DEDALUS-5x/axes-controller-board/outputs/ACB_bom.csv

Reference | Value | Footprint | Qty | LCSC
C1,C2,C3 | 10u | Capacitor_SMD:C_0603_1608Metric | 3 | C19702
C4,C5 | 15pF | Capacitor_SMD:C_0603_1608Metric | 2 | C1644
C6,C32,C33,C34,C39,C40,C41,C46,C47 | 100nF | Capacitor_SMD:C_0603_1608Metric | 9 | C14663
C10,C11 | 4.7u | Capacitor_SMD:C_0805_2012Metric | 2 | C1779
C12,C13,C15,C30,C31,C37,C38,C44,C45 | 10n | Capacitor_SMD:C_0603_1608Metric | 9 | C57112
C25,C26 | 2.2u | Capacitor_SMD:C_0805_2012Metric | 2 | C377773
C35,C36,C42,C43,C49,C50 | 220p | Capacitor_SMD:C_0603_1608Metric | 6 | C1603
D1,D2 | LED_Small | Diode_SMD:D_0603_1608Metric | 2 | C2286
D3 | B540C | Diode_SMD:D_SMC_Handsoldering | 1 | C72264
D5,D6 | LED_Small | LED_SMD:LED_0603_1608Metric | 2 | C2286
F1 | 750mA | Fuse:Fuse_0603_1608Metric | 1 | C206991
IC1 | TPS5450QDDARQ1 | Local:SOIC127P600X170-9N | 1 | C181270
IC5 | STM32H723ZGT6 | Local:QFP50P2200X2200X160-144N | 1 | C7089881
JP1 | BOOT0 | Jumper:SolderJumper-3_P1.3mm_Open_RoundedPad1.0x1.5mm | 1
L2 | 15u | Inductor_SMD:L_12x12mm_H6mm | 1 | C2847584
R1 | 2k | Resistor_SMD:R_0603_1608Metric | 1 | C22975
R2,R10,R11,R41,R42 | 1k | Resistor_SMD:R_0603_1608Metric | 5 | C21190
R3,R4,R5,R6,R7,R19,R20,R21,R22,R23,R24,R25,R26,R27,R28,R29,R30,R31,R32,R43,R44,R58,R59,R71,R72 | 33R | Resistor_SMD:R_0603_1608Metric | 25 | C23140
R8,R33,R34 | 10k | Resistor_SMD:R_0603_1608Metric | 3 | C25804
R9 | 3.16k | Resistor_SMD:R_0603_1608Metric | 1 | C100959
R13,R14,R35,R36,R49,R50 | 120R | Resistor_SMD:R_0603_1608Metric | 6 | C22787
R15,R16,R37,R38,R51,R52 | 1k8 | Resistor_SMD:R_0603_1608Metric | 6 | C4177
R17,R18,R39,R40,R53,R54 | 3k3 | Resistor_SMD:R_0603_1608Metric | 6 | C22978
U1 | LM1117MP-3.3 | Package_TO_SOT_SMD:SOT-223-3_TabPin2 | 1 | C498153
U3,U5,U7 | UA9637A | Package_SO:SOIC-8_3.9x4.9mm_P1.27mm | 3 | C434452
Y1 | 16MHz | Crystal:Crystal_SMD_EuroQuartz_MT-4Pin_3.2x2.5mm | 1 | C27869
