DEDALUS-5x/axes-controller-board/outputs/ACB_schematic.pdf

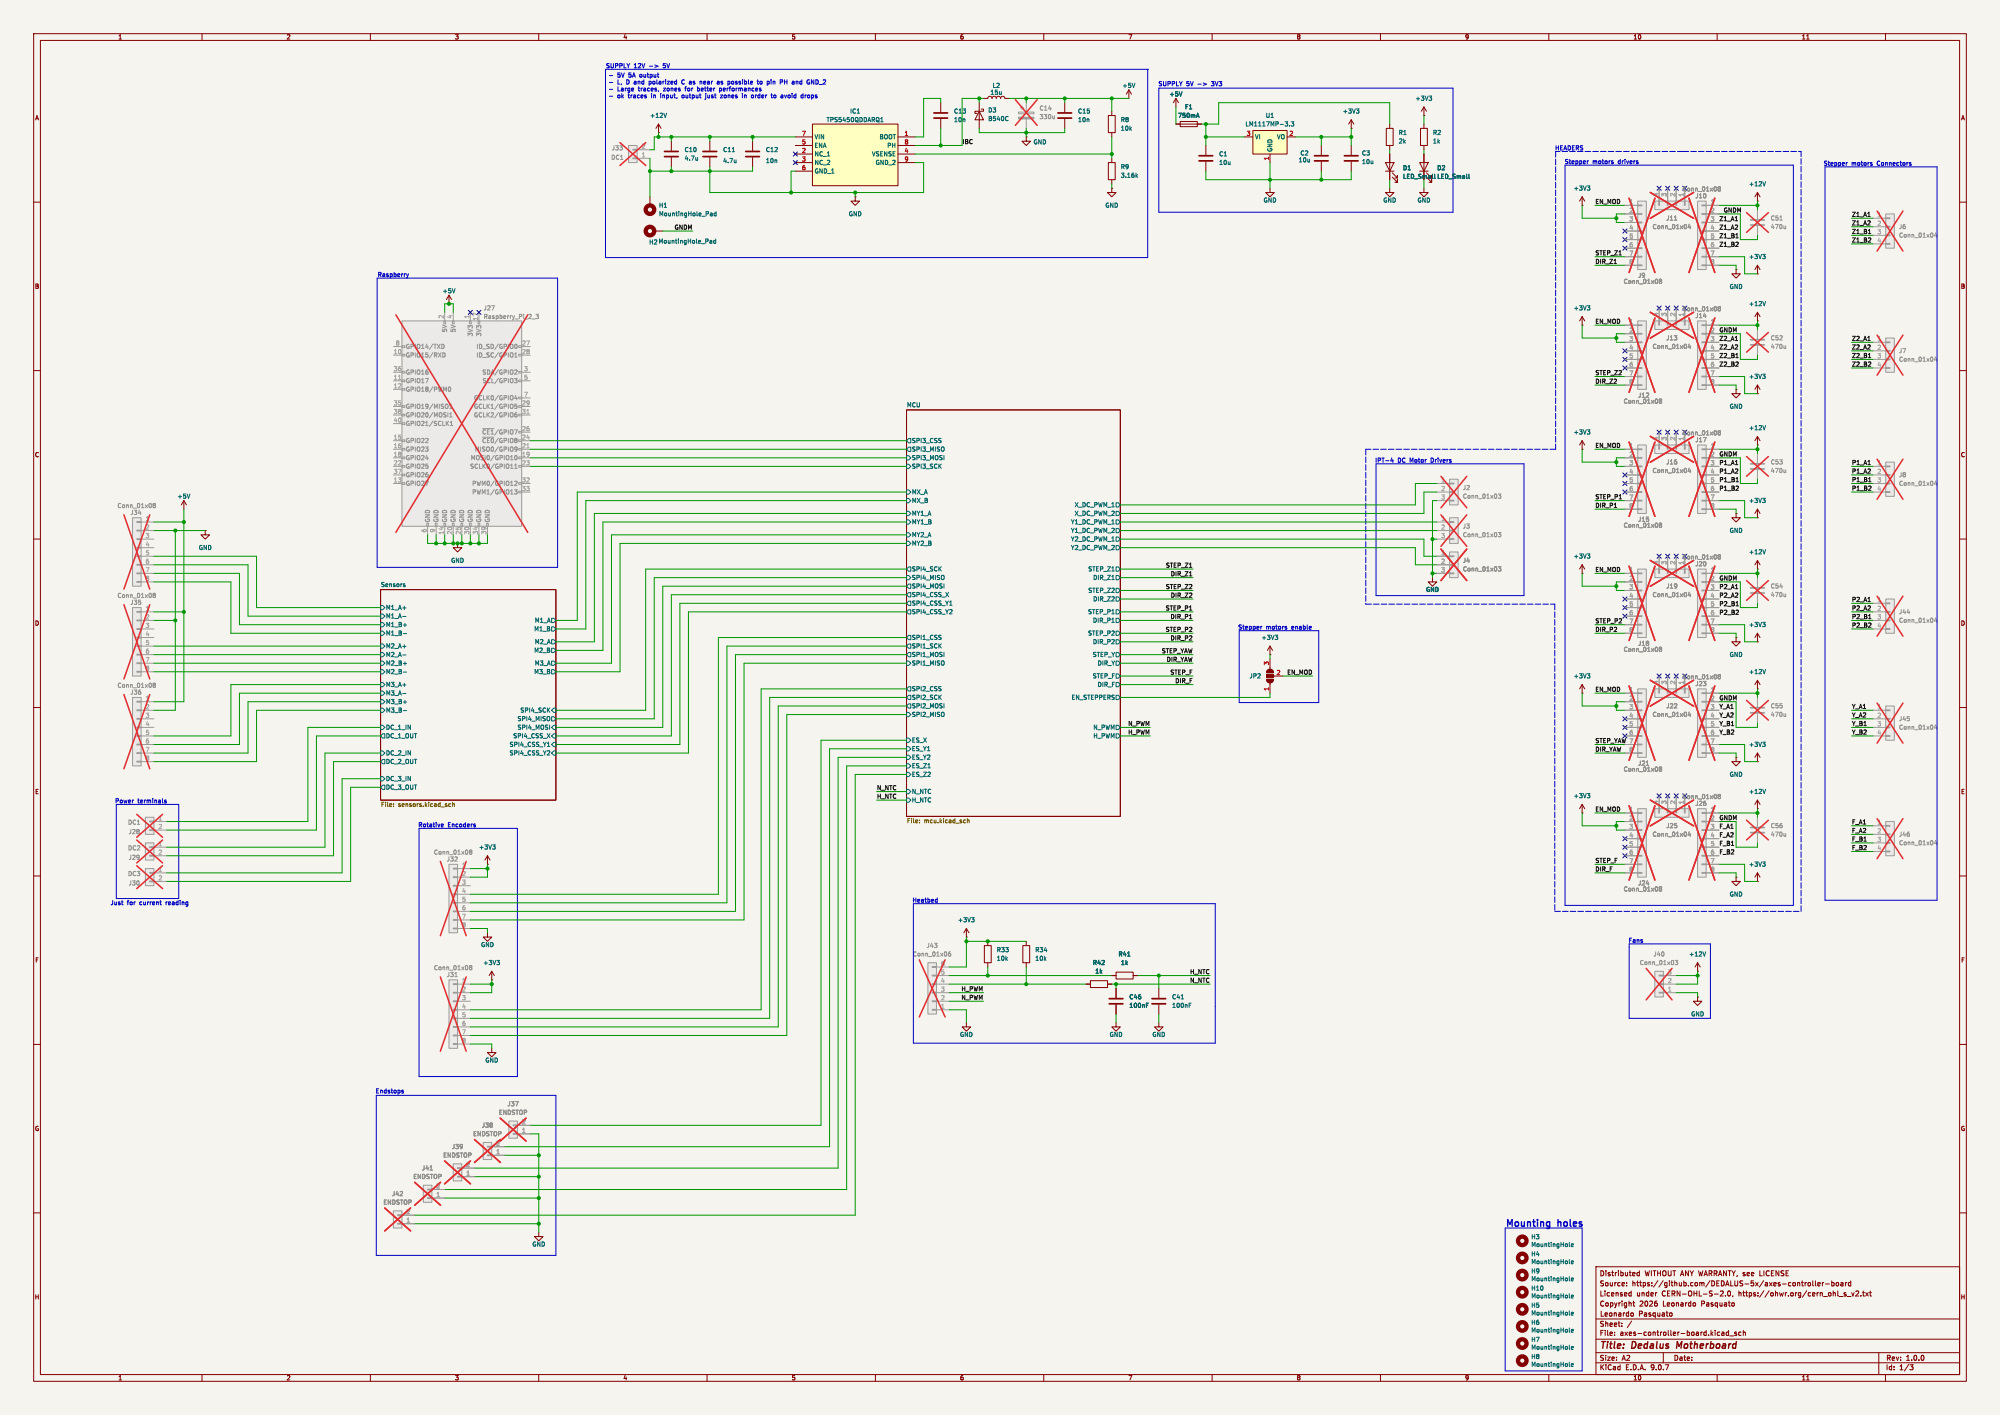
[picture p1: page 1]

Mounting holes
H3 MountingHole H10 MountingHole H9 MountingHole H4 MountingHole H5 MountingHole H8 MountingHole

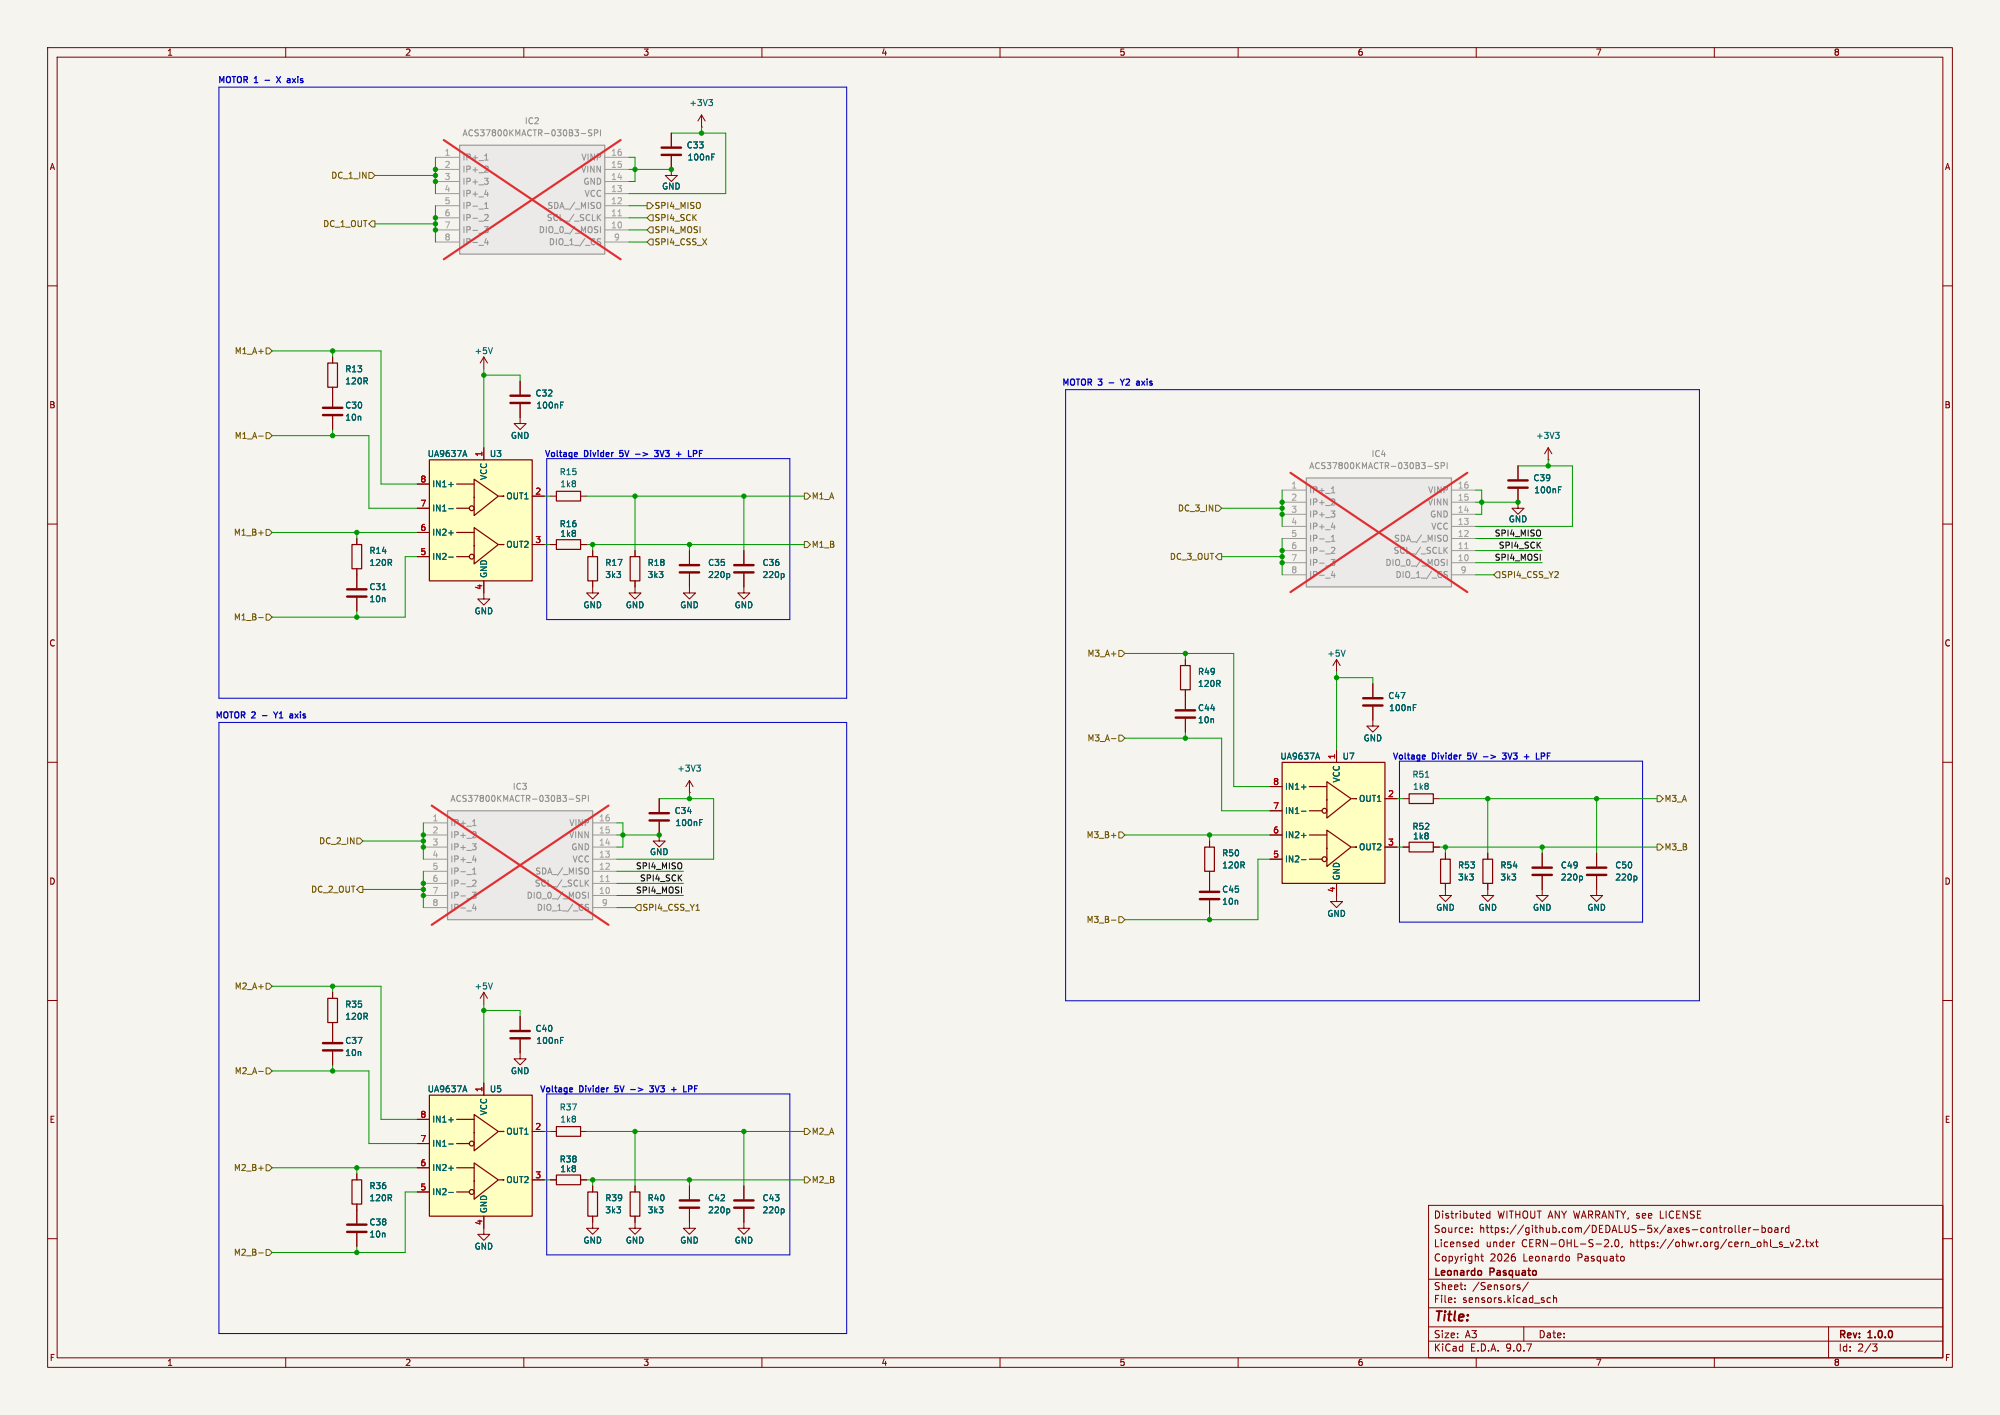
[picture p2: page 2]

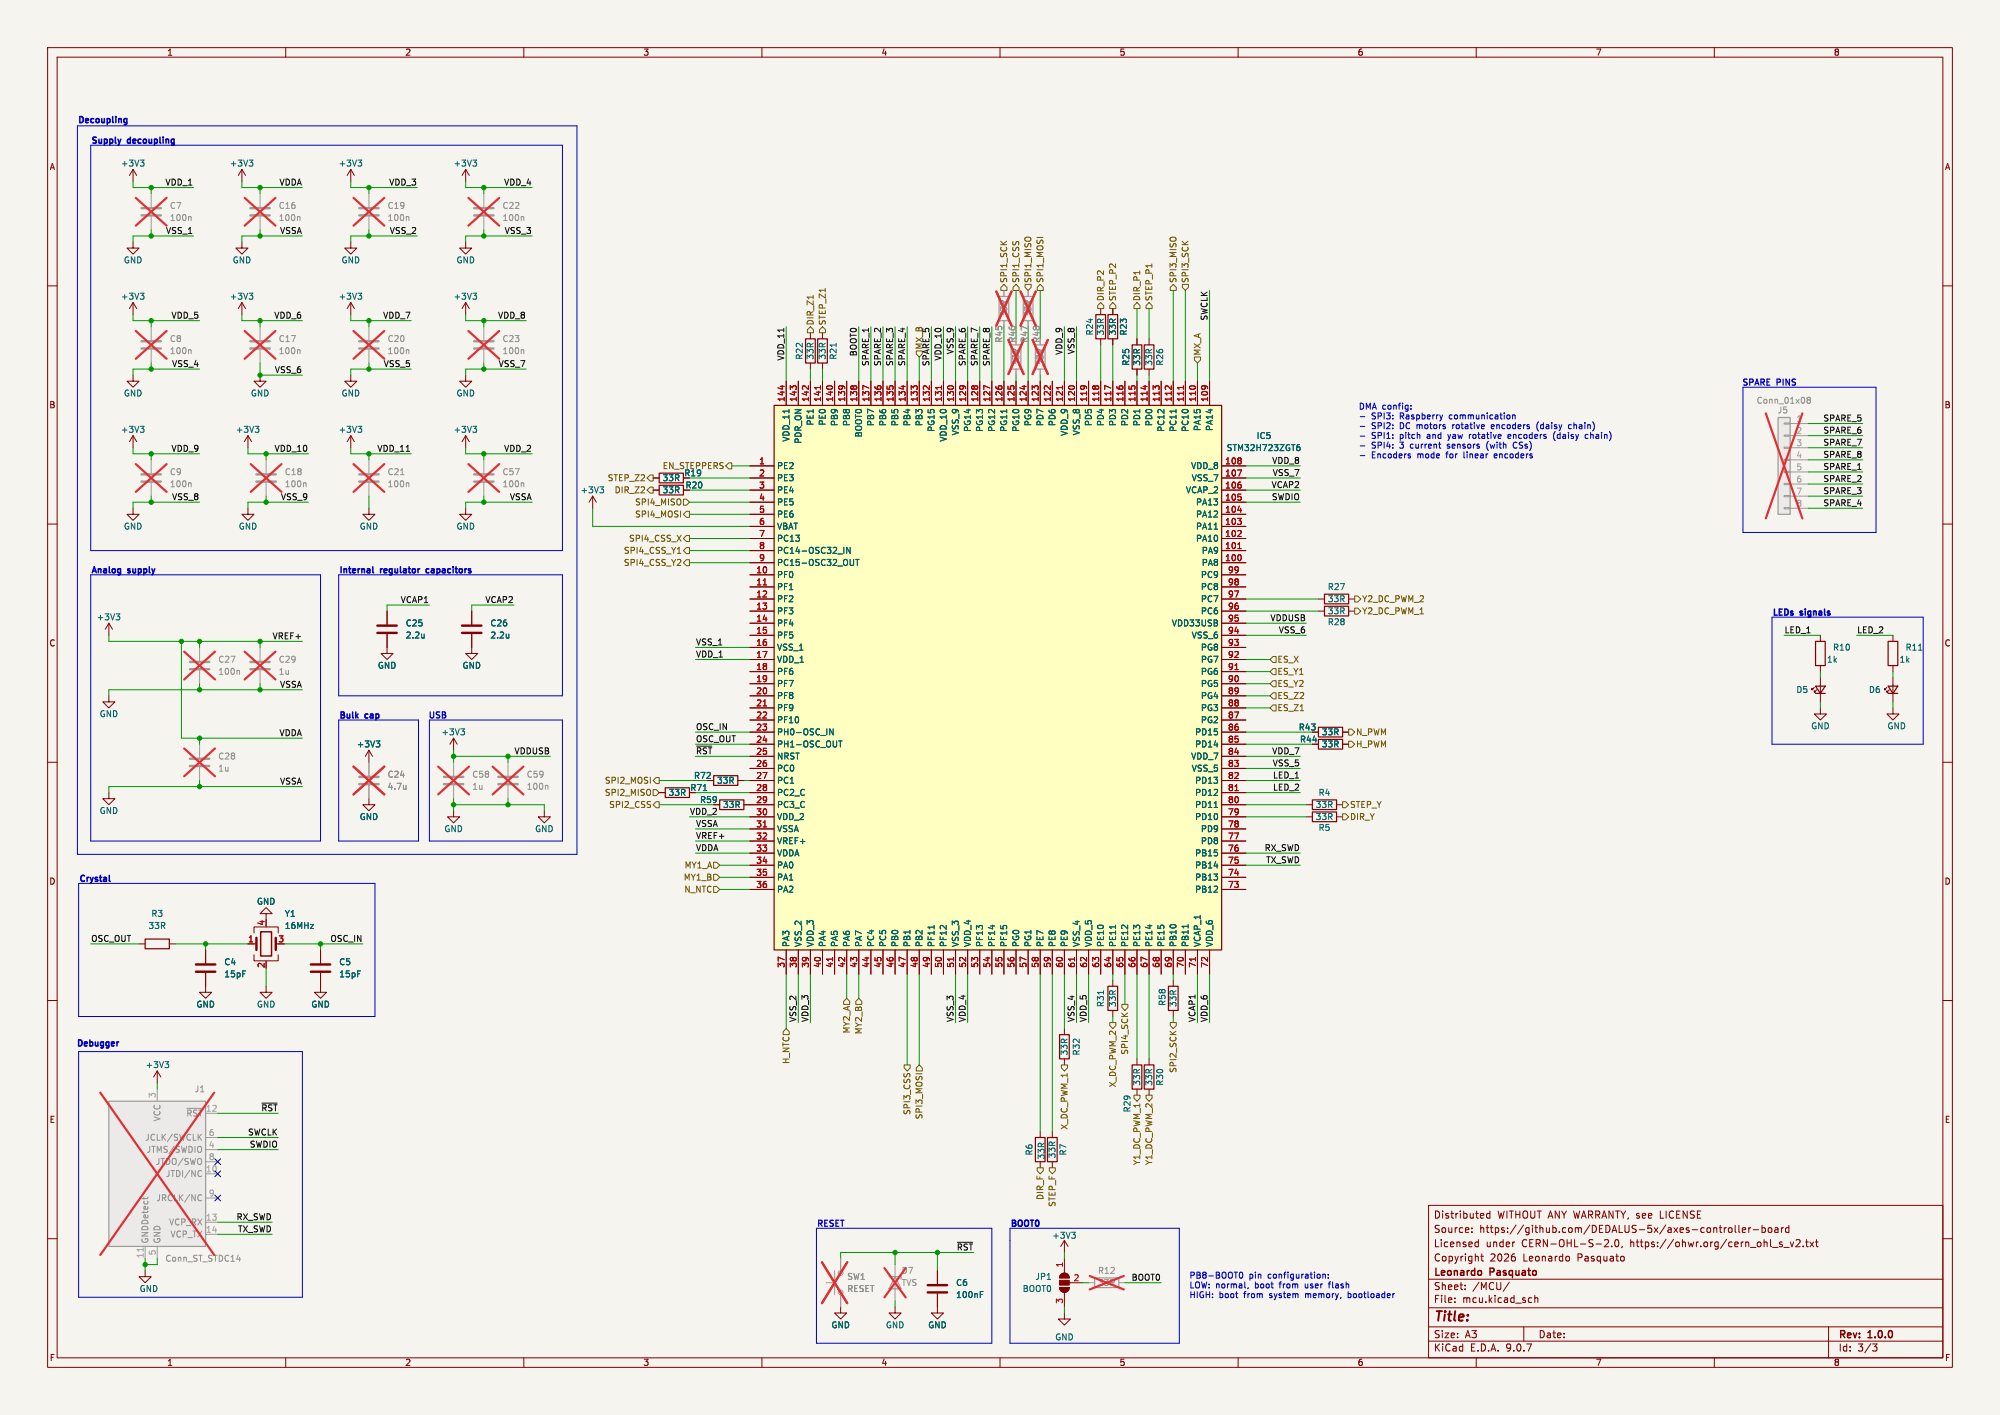
[picture p3: page 3]

DMA config: - SPI3: Raspberry communication

- SPI4: 3 current sensors (with CSs)
