DEDALUS-5x/axes-controller-board/axes-controller-board.kicad_pcb

## KiCad design axes-controller-board.kicad_pcb (2026-11-08)

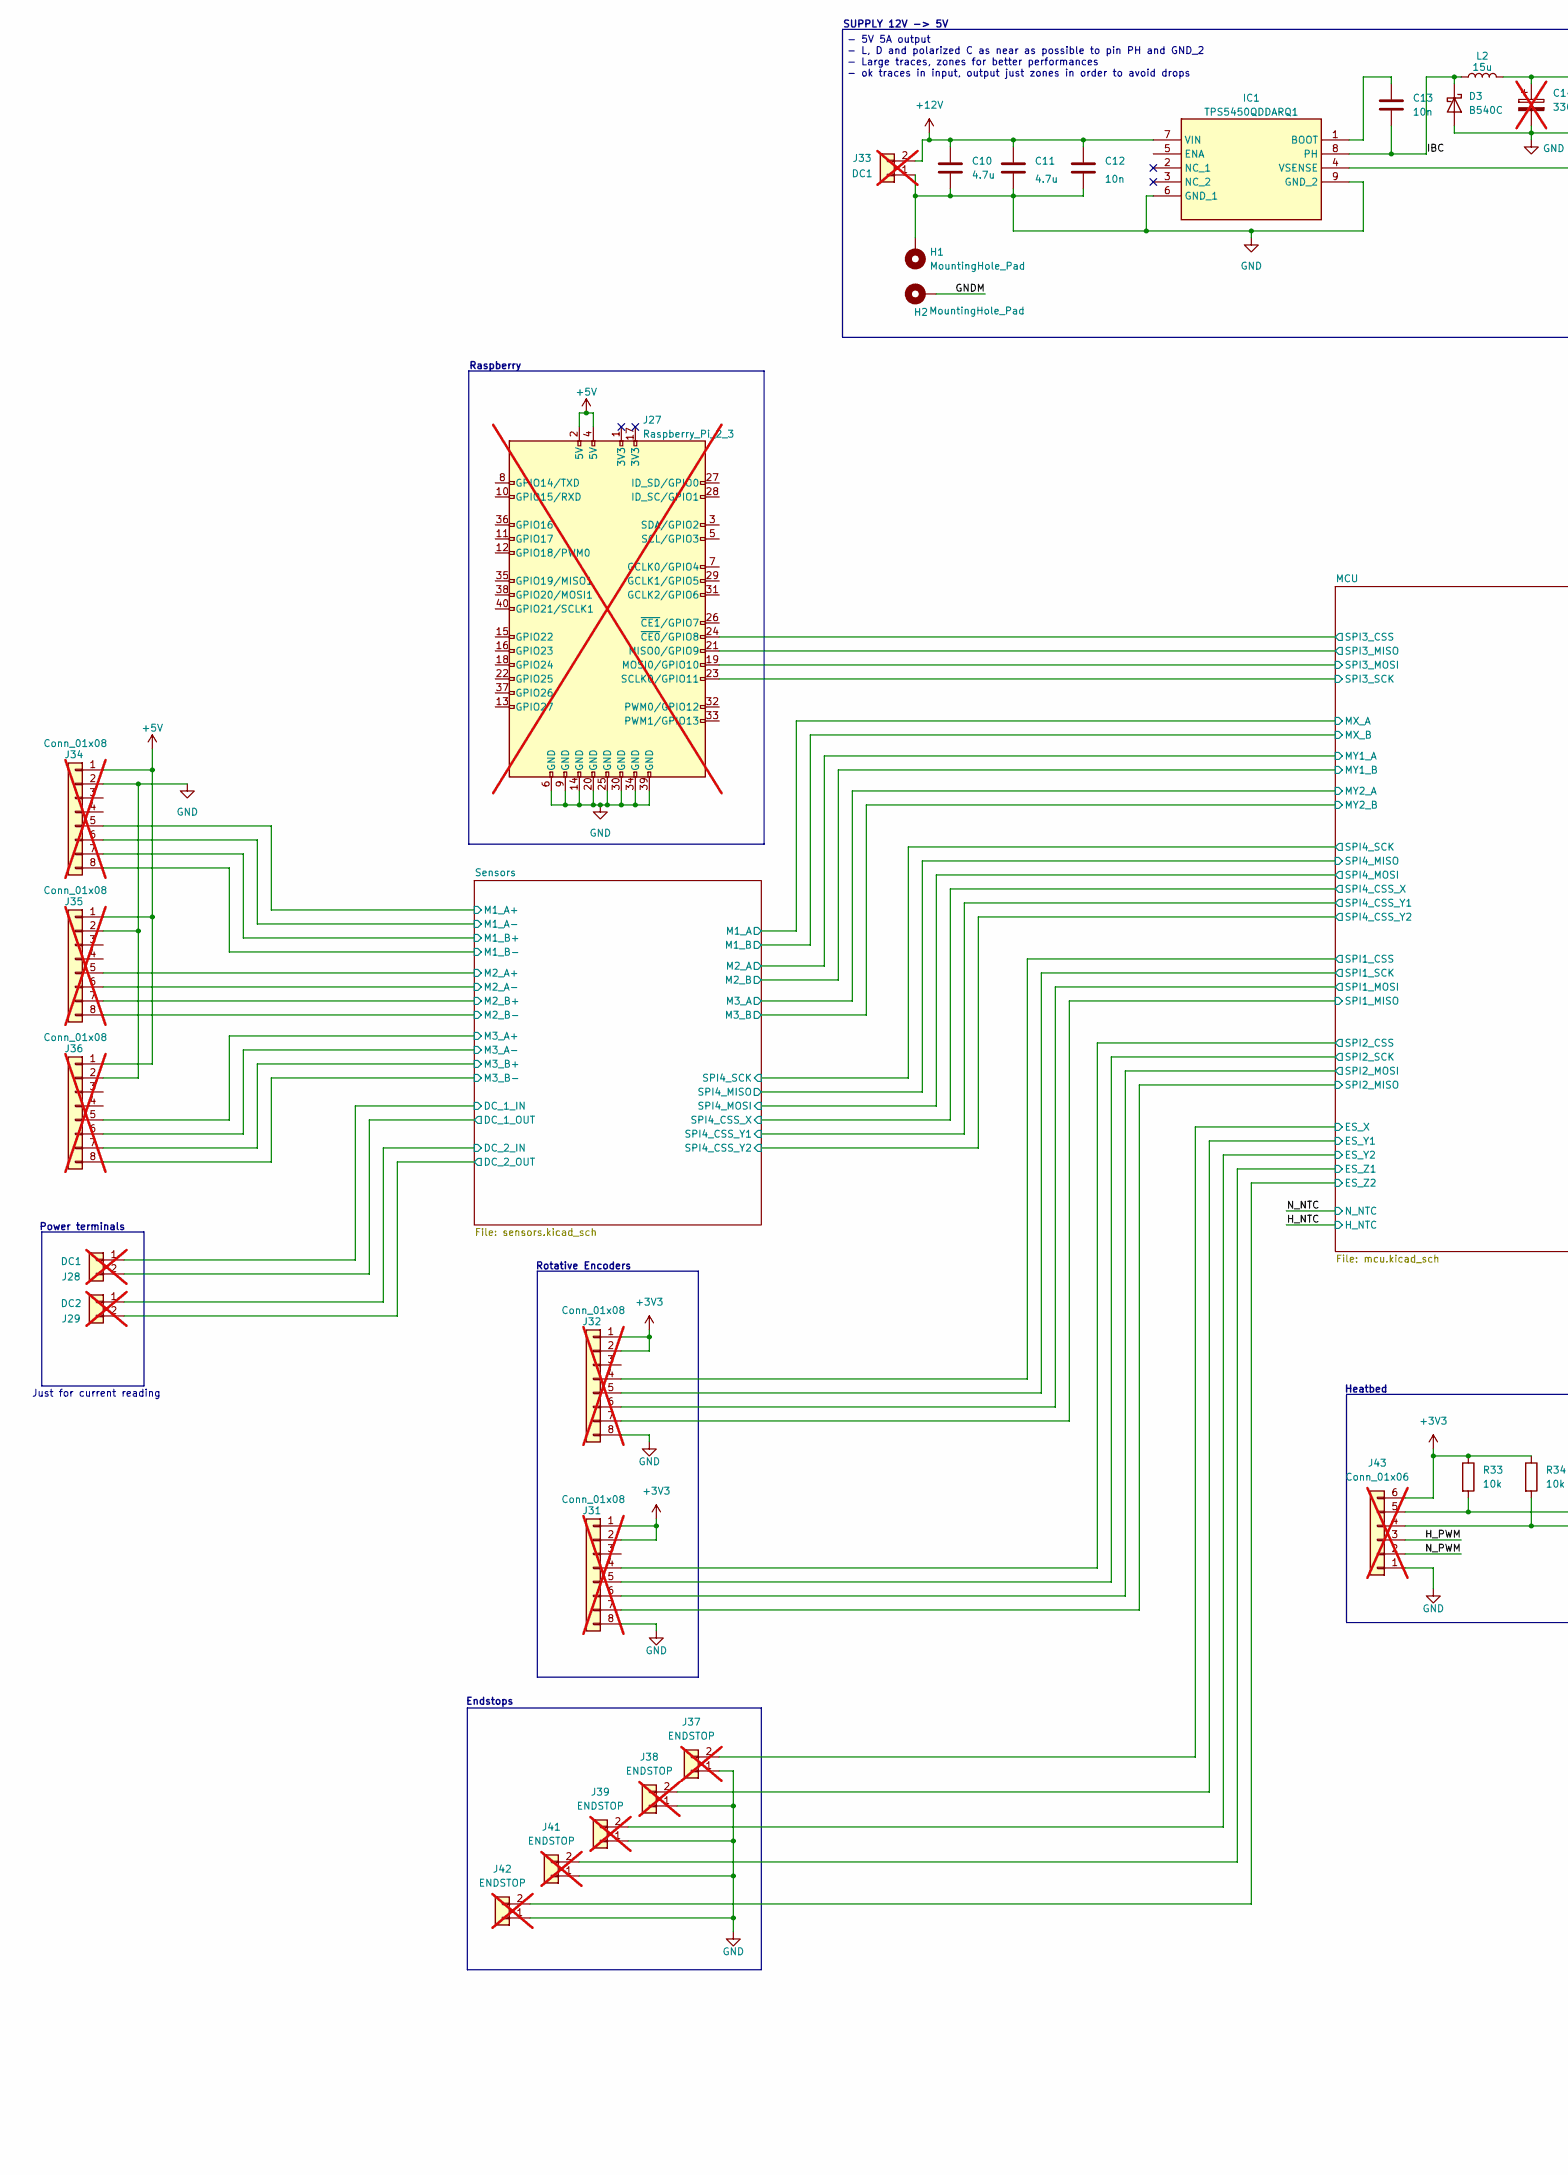
[picture p4: schematic axes-controller-board.kicad_sch, Dedalus Motherboard, part in row 1, column 1]

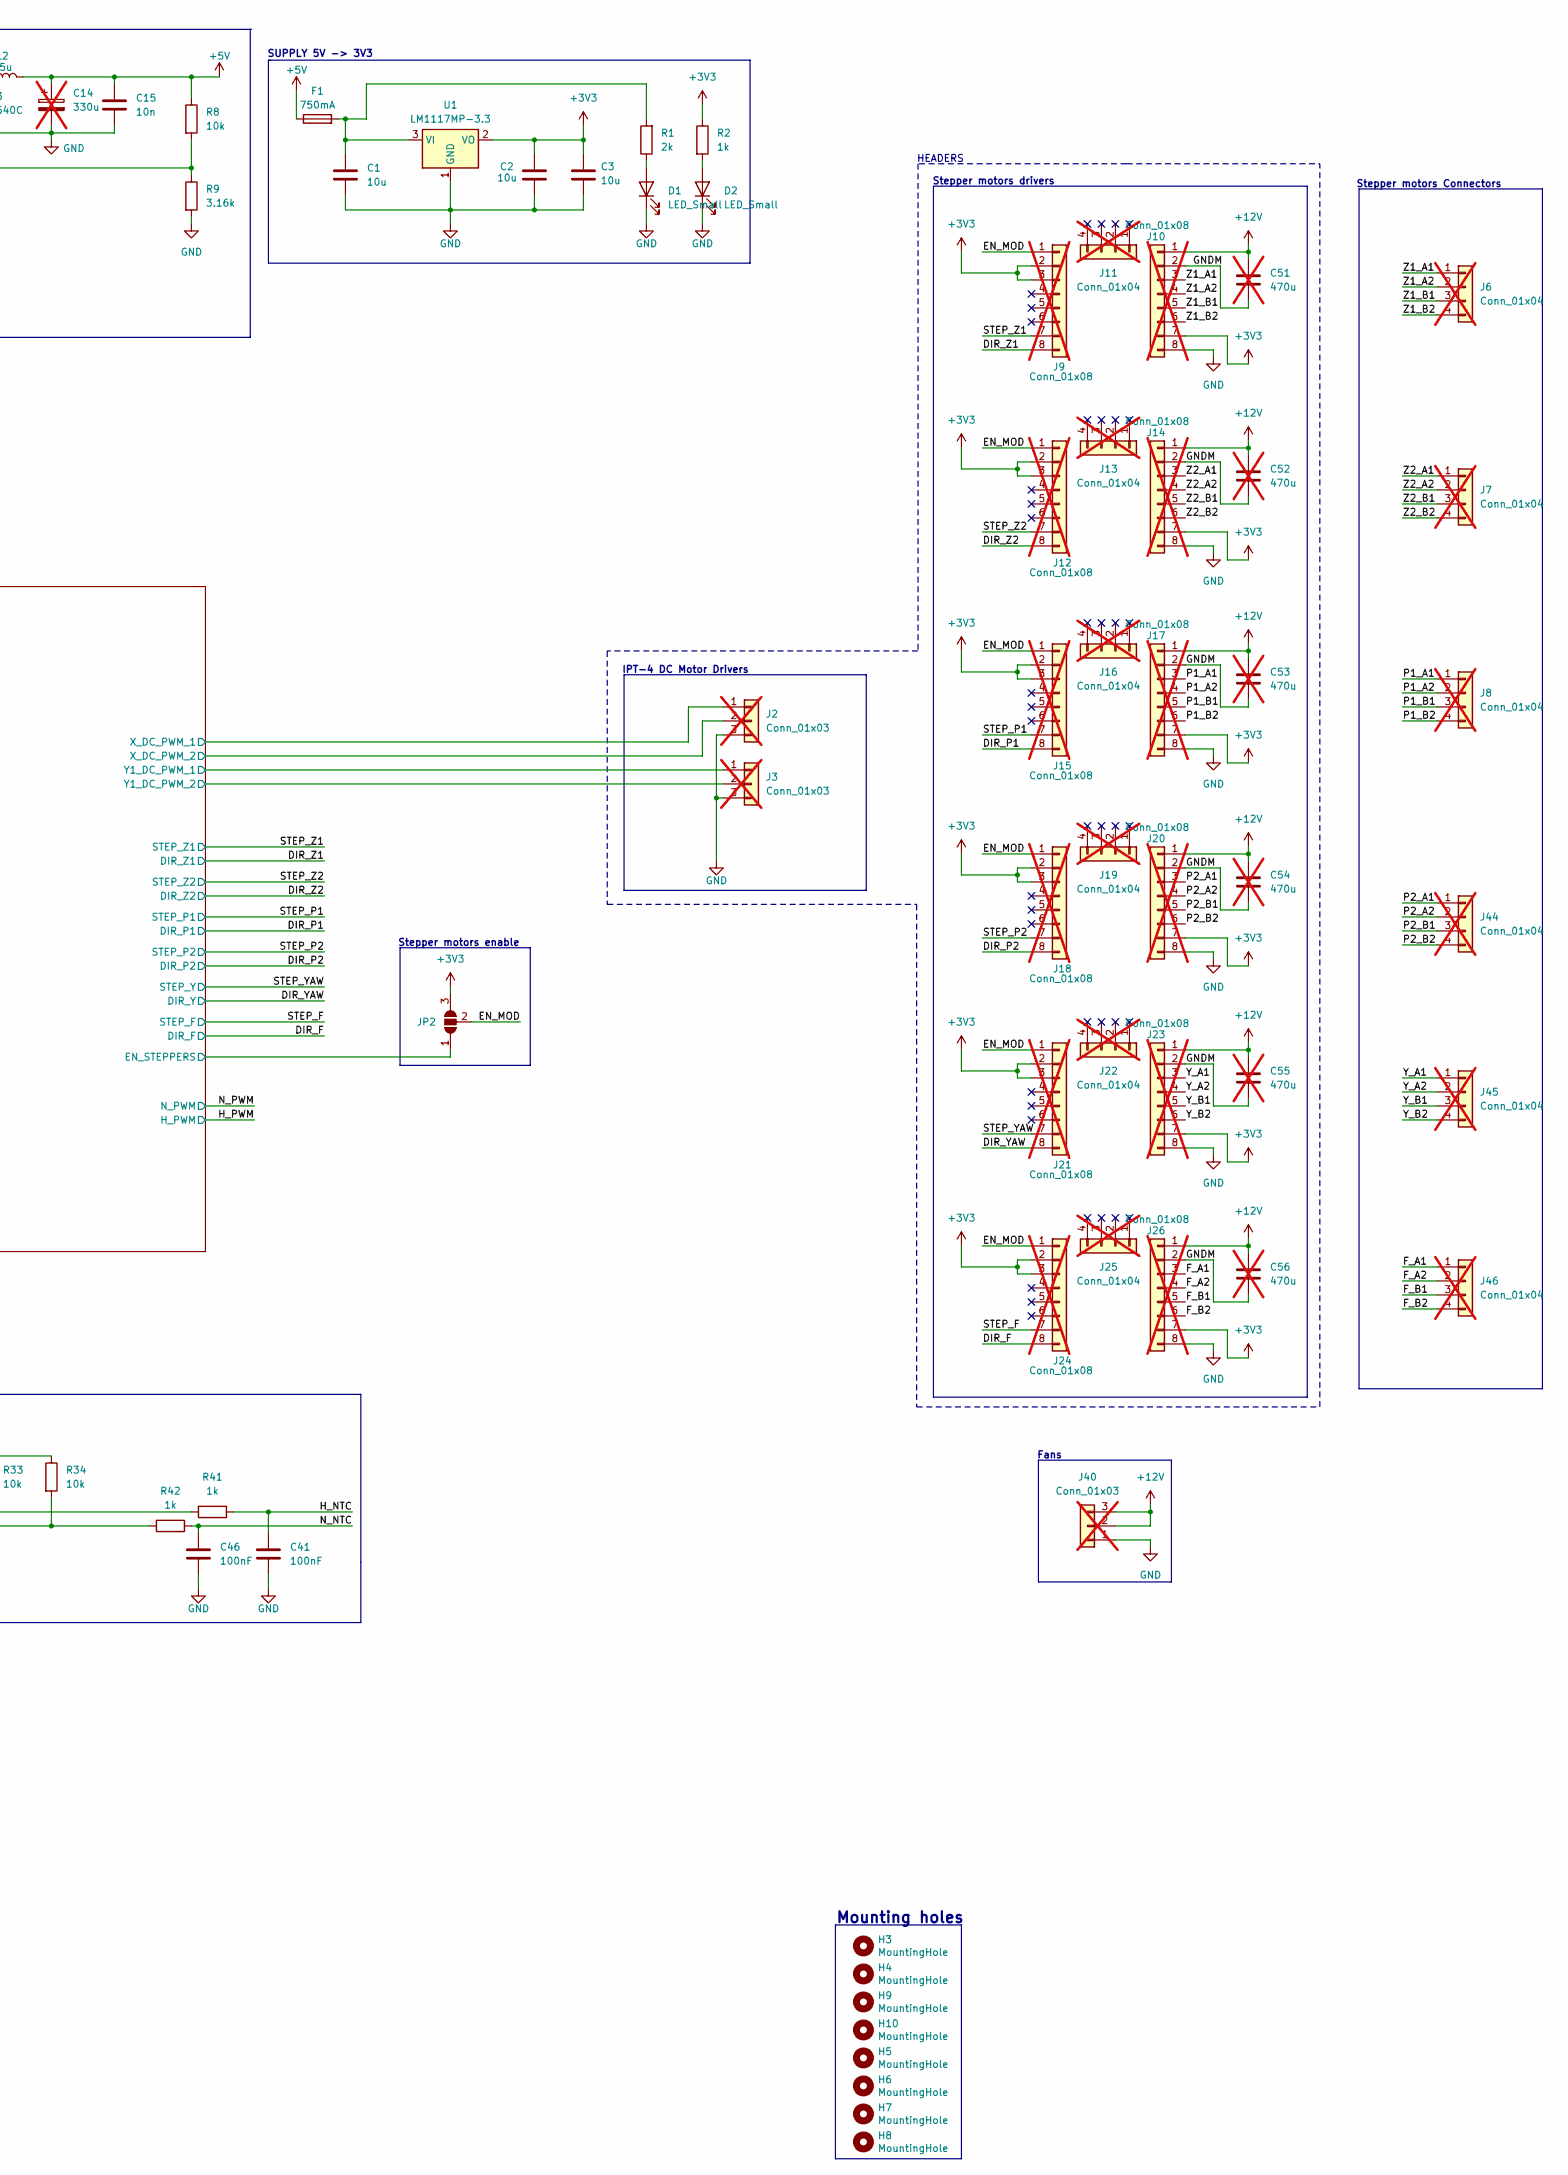
[picture p5: schematic axes-controller-board.kicad_sch, Dedalus Motherboard, part in row 1, column 2]

Parts:
C1, C2, C3: 10u; C_0603_1608Metric; LCSC C19702
C10, C11: 4.7u; C_0805_2012Metric; LCSC C1779
C12, C13, C15: 10n; C_0603_1608Metric; LCSC C57112
C14: 330u; CP_Radial_D10.0mm_P5.00mm; not fitted
C41, C46: 100nF; C_0603_1608Metric; LCSC C14663
C51, C52, C53, C54, C55, C56: 470u; PinHeader_1x02_P1.00mm_Vertical; not fitted
D1, D2: LED_Small; D_0603_1608Metric; MPN TLMS1000-GS15; LCSC C2286
D3: B540C; D_SMC_Handsoldering; LCSC C72264
F1: 750mA; Fuse_0603_1608Metric; LCSC C206991
H1, H2: MountingHole_Pad; TestPoint_GNDedge
H3, H4, H5, H6, H7, H8, H9, H10: MountingHole; MountingHole_3.2mm_M3_ISO14580
IC1: TPS5450QDDARQ1; SOIC127P600X170-9N; Mouser Part Number 595-TPS5450QDDARQ1
J2, J3, J40: Conn_01x03; 1985205; not fitted
J6, J7, J8, J44, J45, J46: Conn_01x04; JST_XH_B4B-XH-A_1x04_P2.50mm_Vertical; not fitted
J9, J10, J12, J14, J15, J17, J18, J20, J21, J23, J24, J26: Conn_01x08; PinHeader_1x08_P2.54mm_Vertical; not fitted
J11, J13, J16, J19, J22, J25: Conn_01x04; PinHeader_1x04_P2.54mm_Vertical; not fitted
J27: Raspberry_Pi_2_3; raspberrypi; MPN 2.54-2*20; LCSC C2977589; not fitted
J28, J33: DC1; TerminalBlock_Phoenix_MKDS-1,5-2-5.08_1x02_P5.08mm_Horizont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; not fitted
J29: DC2; TerminalBlock_Phoenix_MKDS-1,5-2-5.08_1x02_P5.08mm_Horizont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; not fitted
J31, J32, J34, J35, J36: Conn_01x08; 1985250; not fitted
J37, J38, J39, J41, J42: ENDSTOP; PinHeader_1x02_P2.54mm_Vertical; not fitted
J43: Conn_01x06; 1985234; not fitted
JP2: SolderJumper_3_Open; SolderJumper-3_P1.3mm_Open_RoundedPad1.0x1.5mm
L2: 15u; L_12x12mm_H6mm; LCSC C2847584
R1: 2k; R_0603_1608Metric; LCSC C22975
R2, R41, R42: 1k; R_0603_1608Metric; LCSC C21190
R8, R33, R34: 10k; R_0603_1608Metric; LCSC C25804
R9: 3.16k; R_0603_1608Metric; LCSC C100959
U1: LM1117MP-3.3; SOT-223-3_TabPin2; MPN LM1117MP-3.3/TR; LCSC C498153

Connections:
+3V3: C2.1, C3.1, J9.2, J9.3, J10.7, J12.2, J12.3, J14.7, J15.2, J15.3, J17.7, J18.2, J18.3, J20.7, J21.2, J21.3, J23.7, J24.2, J24.3, J26.7, J31.1, J31.2, J32.1, J32.2, J43.6, JP2.3 (B), R2.1, R33.1, R34.1, U1.2 (VO); also elsewhere on the board
+5V: C14.1, C15.1, F1.1, J27.2 (5V), J27.4 (5V), J34.1, J35.1, J36.1, L2.2, R8.1; also elsewhere on the board
+12V: C10.1, C11.1, C12.1, C51.1, C52.1, C53.1, C54.1, C55.1, C56.1, IC1.7 (VIN), J10.1, J14.1, J17.1, J20.1, J23.1, J26.1, J33.2, J40.2, J40.3
/DIR_F: J24.8; also elsewhere on the board
/DIR_P1: J15.8; also elsewhere on the board
/DIR_P2: J18.8; also elsewhere on the board
/DIR_YAW: J21.8; also elsewhere on the board
/DIR_Z1: J9.8; also elsewhere on the board
/DIR_Z2: J12.8; also elsewhere on the board
/EN_MOD: J9.1, J12.1, J15.1, J18.1, J21.1, J24.1, JP2.2 (C)
/F_A1: J26.3, J46.1
/F_A2: J26.4, J46.2
/F_B1: J26.5, J46.3
/F_B2: J26.6, J46.4
/GNDM: C51.2, C52.2, C53.2, C54.2, C55.2, C56.2, H2.1, J10.2, J14.2, J17.2, J20.2, J23.2, J26.2
/H_NTC: C41.1, R41.1; also elsewhere on the board
/H_PWM: J43.3; also elsewhere on the board
/IBC: C13.1, D3.1 (K), IC1.8 (PH), L2.1
/MCU/EN_STEPPERS: JP2.1 (A); also elsewhere on the board
/MCU/ES_X: J37.2; also elsewhere on the board
/MCU/ES_Y1: J38.2; also elsewhere on the board
/MCU/ES_Y2: J39.2; also elsewhere on the board
/MCU/ES_Z1: J41.2; also elsewhere on the board
/MCU/ES_Z2: J42.2; also elsewhere on the board
/MCU/SPI1_CSS: J32.4; also elsewhere on the board
/MCU/SPI1_MISO: J32.7; also elsewhere on the board
/MCU/SPI1_MOSI: J32.6; also elsewhere on the board
/MCU/SPI1_SCK: J32.5; also elsewhere on the board
/MCU/SPI2_CSS: J31.4; also elsewhere on the board
/MCU/SPI2_MISO: J31.7; also elsewhere on the board
/MCU/SPI2_MOSI: J31.6; also elsewhere on the board
/MCU/SPI2_SCK: J31.5; also elsewhere on the board
/MCU/SPI3_CSS: J27.24 (~CE0/GPIO8); also elsewhere on the board
/MCU/SPI3_MISO: J27.21 (MISO0/GPIO9); also elsewhere on the board
/MCU/SPI3_MOSI: J27.19 (MOSI0/GPIO10); also elsewhere on the board
/MCU/SPI3_SCK: J27.23 (SCLK0/GPIO11); also elsewhere on the board
/MCU/X_DC_PWM_1: J2.1; also elsewhere on the board
/MCU/X_DC_PWM_2: J2.2; also elsewhere on the board
/MCU/Y1_DC_PWM_1: J3.1; also elsewhere on the board
/MCU/Y1_DC_PWM_2: J3.2; also elsewhere on the board
/N_NTC: C46.1, R42.1; also elsewhere on the board
/N_PWM: J43.2; also elsewhere on the board
/P1_A1: J8.1, J17.3
/P1_A2: J8.2, J17.4
/P1_B1: J8.3, J17.5
/P1_B2: J8.4, J17.6
/P2_A1: J20.3, J44.1
/P2_A2: J20.4, J44.2
/P2_B1: J20.5, J44.3
/P2_B2: J20.6, J44.4
/STEP_F: J24.7; also elsewhere on the board
/STEP_P1: J15.7; also elsewhere on the board
/STEP_P2: J18.7; also elsewhere on the board
/STEP_YAW: J21.7; also elsewhere on the board
/STEP_Z1: J9.7; also elsewhere on the board
/STEP_Z2: J12.7; also elsewhere on the board
/Sensors/DC_1_IN: J28.1; also elsewhere on the board
/Sensors/DC_1_OUT: J28.2; also elsewhere on the board
/Sensors/DC_2_IN: J29.1; also elsewhere on the board
/Sensors/DC_2_OUT: J29.2; also elsewhere on the board
/Sensors/M1_A+: J34.5; also elsewhere on the board
/Sensors/M1_A-: J34.6; also elsewhere on the board
/Sensors/M1_B+: J34.7; also elsewhere on the board
/Sensors/M1_B-: J34.8; also elsewhere on the board
/Sensors/M2_A+: J35.5; also elsewhere on the board
/Sensors/M2_A-: J35.6; also elsewhere on the board
/Sensors/M2_B+: J35.7; also elsewhere on the board
/Sensors/M2_B-: J35.8; also elsewhere on the board
/Sensors/M3_A+: J36.5; also elsewhere on the board
/Sensors/M3_A-: J36.6; also elsewhere on the board
/Sensors/M3_B+: J36.7; also elsewhere on the board
/Sensors/M3_B-: J36.8; also elsewhere on the board
/Y_A1: J23.3, J45.1
/Y_A2: J23.4, J45.2
/Y_B1: J23.5, J45.3
/Y_B2: J23.6, J45.4
/Z1_A1: J6.1, J10.3
/Z1_A2: J6.2, J10.4
/Z1_B1: J6.3, J10.5
/Z1_B2: J6.4, J10.6
/Z2_A1: J7.1, J14.3
/Z2_A2: J7.2, J14.4
/Z2_B1: J7.3, J14.5
/Z2_B2: J7.4, J14.6
GND: C1.2, C2.2, C3.2, C10.2, C11.2, C12.2, C14.2, C15.2, C41.2, C46.2, D1.1 (K), D2.1 (K), D3.2 (A), H1.1, IC1.6 (GND_1), IC1.9 (GND_2), J2.3, J3.3, J10.8, J14.8, J17.8, J20.8, J23.8, J26.8, J27.6 (GND), J27.9 (GND), J27.14 (GND), J27.20 (GND), J27.25 (GND), J27.30 (GND), J27.34 (GND), J27.39 (GND), J31.8, J32.8, J33.1, J34.2, J35.2, J36.2, J37.1, J38.1, J39.1, J40.1, J41.1, J42.1, J43.1, R9.2, U1.1 (GND); also elsewhere on the board
unnamed: D1.2 (A), R1.1
unnamed: D2.2 (A), R2.2
unnamed: C13.2, IC1.1 (BOOT)
unnamed: IC1.4 (VSENSE), R8.2, R9.1
unnamed: J43.4, R34.2, R42.2
unnamed: J43.5, R33.2, R41.2
unnamed: C1.1, F1.2, R1.2, U1.3 (VI)

Notes on the sheet:
Stepper motors Connectors
Just for current reading
SUPPLY 12V -> 5V
Stepper motors drivers
Fans
Heatbed
Mounting holes
IPT-4 DC Motor Drivers
SUPPLY 5V -> 3V3
HEADERS
Raspberry
Power terminals
Endstops
Rotative Encoders
- 5V 5A output - L, D and polarized C as near as possible to pin PH and GND_2 - Large traces, zones for better performances - ok traces in input, output just zones in order to avoid drops
Stepper motors enable

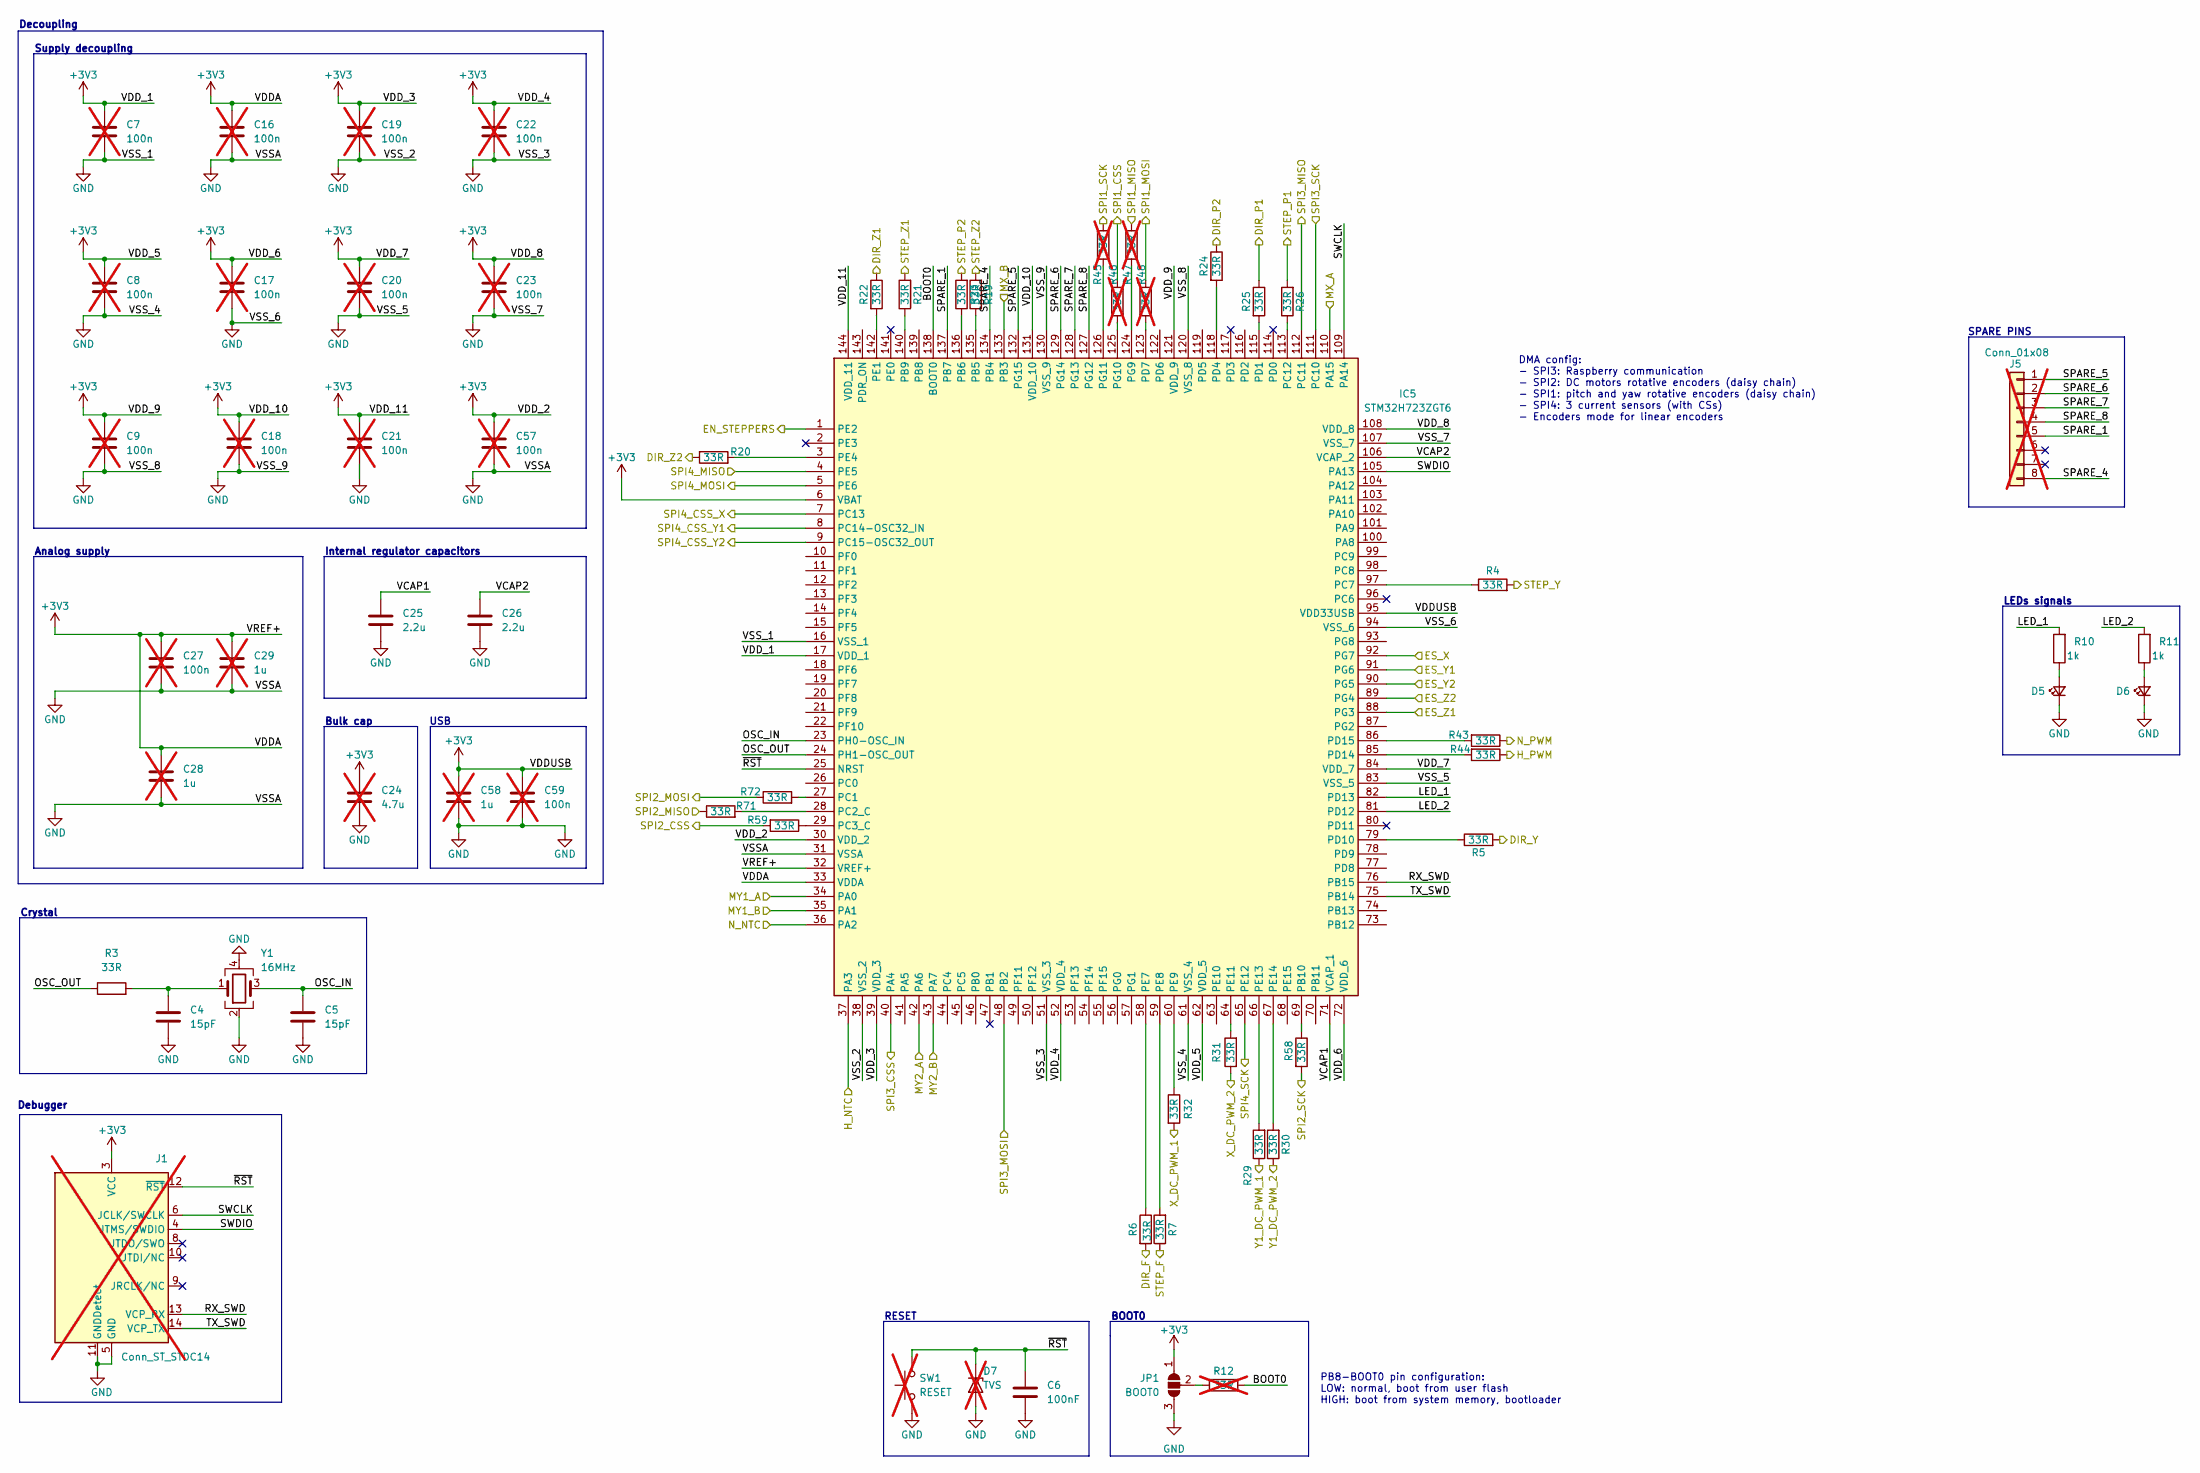
[picture p6: schematic mcu.kicad_sch]

Parts:
C4, C5: 15pF; C_0603_1608Metric; LCSC C1644
C6: 100nF; C_0603_1608Metric; LCSC C14663
C7, C8, C9, C16, C17, C18, C19, C20, C21, C22, C23, C27, C57, C59: 100n; C_0603_1608Metric; not fitted
C24: 4.7u; C_0805_2012Metric; not fitted
C25, C26: 2.2u; C_0805_2012Metric; LCSC C377773
C28, C29, C58: 1u; C_0805_2012Metric; not fitted
D5, D6: LED_Small; LED_0603_1608Metric; LCSC C2286
D7: TVS; D_SOD-523; not fitted
IC5: STM32H723ZGT6; QFP50P2200X2200X160-144N; Mouser Part Number 511-STM32H723ZGT6
J1: Conn_ST_STDC14; SAMTEC_FTSH-107-01-L-DV-K-TR; not fitted
J5: Conn_01x08; PinHeader_1x08_P2.54mm_Vertical; not fitted
JP1: BOOT0; SolderJumper-3_P1.3mm_Open_RoundedPad1.0x1.5mm
R3, R4, R5, R6, R7, R19, R20, R21, R22, R23, R24, R25, R26, R29, R30, R31, R32, R43, R44, R58, R59, R71, R72: 33R; R_0603_1608Metric; LCSC C23140
R10, R11: 1k; R_0603_1608Metric; LCSC C21190
R12: 33R; R_0603_1608Metric; not fitted
R45, R46, R47, R48: 33R; R_0603_1608Metric; LCSC C23140; not fitted
SW1: RESET; SW_SPST_FSMSM; not fitted
Y1: 16MHz; Crystal_SMD_EuroQuartz_MT-4Pin_3.2x2.5mm; LCSC C27869

Connections:
+3V3: C7.1, C8.1, C9.1, C16.1, C17.1, C18.1, C19.1, C20.1, C21.1, C22.1, C23.1, C24.1, C27.1, C28.1, C29.1, C57.1, C58.1, C59.1, IC5.6 (VBAT), IC5.17 (VDD_1), IC5.30 (VDD_2), IC5.32 (VREF+), IC5.33 (VDDA), IC5.39 (VDD_3), IC5.52 (VDD_4), IC5.62 (VDD_5), IC5.72 (VDD_6), IC5.84 (VDD_7), IC5.95 (VDD33USB), IC5.108 (VDD_8), IC5.121 (VDD_9), IC5.131 (VDD_10), IC5.144 (VDD_11), J1.3 (VCC), JP1.1 (A); also elsewhere on the board
/DIR_F: R6.2; also elsewhere on the board
/DIR_P1: R25.1; also elsewhere on the board
/DIR_P2: R24.1; also elsewhere on the board
/DIR_YAW: R5.2; also elsewhere on the board
/DIR_Z1: R22.1; also elsewhere on the board
/DIR_Z2: R20.1; also elsewhere on the board
/H_NTC: IC5.37 (PA3); also elsewhere on the board
/H_PWM: R44.1; also elsewhere on the board
/MCU/BOOT0: IC5.138 (BOOT0), R12.2
/MCU/EN_STEPPERS: IC5.1 (PE2); also elsewhere on the board
/MCU/ES_X: IC5.92 (PG7); also elsewhere on the board
/MCU/ES_Y1: IC5.91 (PG6); also elsewhere on the board
/MCU/ES_Y2: IC5.90 (PG5); also elsewhere on the board
/MCU/ES_Z1: IC5.88 (PG3); also elsewhere on the board
/MCU/ES_Z2: IC5.89 (PG4); also elsewhere on the board
/MCU/LED_1: IC5.82 (PD13), R10.2
/MCU/LED_2: IC5.81 (PD12), R11.2
/MCU/MX_A: IC5.110 (PA15); also elsewhere on the board
/MCU/MX_B: IC5.133 (PB3); also elsewhere on the board
/MCU/MY1_A: IC5.34 (PA0); also elsewhere on the board
/MCU/MY1_B: IC5.35 (PA1); also elsewhere on the board
/MCU/MY2_A: IC5.42 (PA6); also elsewhere on the board
/MCU/MY2_B: IC5.43 (PA7); also elsewhere on the board
/MCU/OSC_IN: C5.1, IC5.23 (PH0-OSC_IN), Y1.3
/MCU/OSC_OUT: IC5.24 (PH1-OSC_OUT), R3.1
/MCU/RX_SWD: IC5.76 (PB15), J1.13 (VCP_RX)
/MCU/SPARE_1: IC5.137 (PB7), J5.5
/MCU/SPARE_4: IC5.134 (PB4), J5.8
/MCU/SPARE_5: IC5.132 (PG15), J5.1
/MCU/SPARE_6: IC5.129 (PG14), J5.2
/MCU/SPARE_7: IC5.128 (PG13), J5.3
/MCU/SPARE_8: IC5.127 (PG12), J5.4
/MCU/SPI1_CSS: R46.1; also elsewhere on the board
/MCU/SPI1_MISO: R47.1; also elsewhere on the board
/MCU/SPI1_MOSI: R48.1; also elsewhere on the board
/MCU/SPI1_SCK: R45.1; also elsewhere on the board
/MCU/SPI2_CSS: R59.2; also elsewhere on the board
/MCU/SPI2_MISO: R71.1; also elsewhere on the board
/MCU/SPI2_MOSI: R72.1; also elsewhere on the board
/MCU/SPI2_SCK: R58.2; also elsewhere on the board
/MCU/SPI3_CSS: IC5.40 (PA4); also elsewhere on the board
/MCU/SPI3_MISO: IC5.112 (PC11); also elsewhere on the board
/MCU/SPI3_MOSI: IC5.48 (PB2); also elsewhere on the board
/MCU/SPI3_SCK: IC5.111 (PC10); also elsewhere on the board
/MCU/SPI4_CSS_X: IC5.7 (PC13); also elsewhere on the board
/MCU/SPI4_CSS_Y1: IC5.8 (PC14-OSC32_IN); also elsewhere on the board
/MCU/SPI4_CSS_Y2: IC5.9 (PC15-OSC32_OUT); also elsewhere on the board
/MCU/SWCLK: IC5.109 (PA14), J1.6 (JCLK/SWCLK)
/MCU/SWDIO: IC5.105 (PA13), J1.4 (JTMS/SWDIO)
/MCU/TX_SWD: IC5.75 (PB14), J1.14 (VCP_TX)
/MCU/VCAP1: C25.1, IC5.71 (VCAP_1)
/MCU/VCAP2: C26.1, IC5.106 (VCAP_2)
/MCU/X_DC_PWM_1: R32.2; also elsewhere on the board
/MCU/X_DC_PWM_2: R31.1; also elsewhere on the board
/MCU/Y1_DC_PWM_1: R29.1; also elsewhere on the board
/MCU/Y1_DC_PWM_2: R30.1; also elsewhere on the board
/MCU/~RST: C6.1, D7.1 (K), IC5.25 (NRST), J1.12 (~RST), SW1.2
/N_NTC: IC5.36 (PA2); also elsewhere on the board
/N_PWM: R43.1; also elsewhere on the board
/STEP_F: R7.1; also elsewhere on the board
/STEP_P1: R26.2; also elsewhere on the board
/STEP_P2: R23.2; also elsewhere on the board
/STEP_YAW: R4.2; also elsewhere on the board
/STEP_Z1: R21.2; also elsewhere on the board
/STEP_Z2: R19.2; also elsewhere on the board
/Sensors/SPI4_MISO: IC5.4 (PE5); also elsewhere on the board
/Sensors/SPI4_MOSI: IC5.5 (PE6); also elsewhere on the board
/Sensors/SPI4_SCK: IC5.65 (PE12); also elsewhere on the board
GND: C4.2, C5.2, C6.2, C7.2, C8.2, C9.2, C16.2, C17.2, C18.2, C19.2, C20.2, C21.2, C22.2, C23.2, C24.2, C25.2, C26.2, C27.2, C28.2, C29.2, C57.2, C58.2, C59.2, D5.1 (K), D6.1 (K), D7.2 (A), IC5.16 (VSS_1), IC5.31 (VSSA), IC5.38 (VSS_2), IC5.51 (VSS_3), IC5.61 (VSS_4), IC5.83 (VSS_5), IC5.94 (VSS_6), IC5.107 (VSS_7), IC5.120 (VSS_8), IC5.130 (VSS_9), J1.5 (GND), J1.7 (GND), J1.11 (GNDDetect), JP1.3 (B), SW1.1, Y1.2, Y1.4; also elsewhere on the board
unnamed: C4.1, R3.2, Y1.1
unnamed: D5.2 (A), R10.1
unnamed: D6.2 (A), R11.1
unnamed: IC5.135 (PB5), R19.1
unnamed: IC5.136 (PB6), R23.1
unnamed: IC5.140 (PB9), R21.1
unnamed: IC5.69 (PB10), R58.1
unnamed: IC5.27 (PC1), R72.2
unnamed: IC5.28 (PC2_C), R71.2
unnamed: IC5.29 (PC3_C), R59.1
unnamed: IC5.97 (PC7), R4.1
unnamed: IC5.113 (PC12), R26.1
unnamed: IC5.115 (PD1), R25.2
unnamed: IC5.118 (PD4), R24.2
unnamed: IC5.123 (PD7), R48.2
unnamed: IC5.79 (PD10), R5.1
unnamed: IC5.85 (PD14), R44.2
unnamed: IC5.86 (PD15), R43.2
unnamed: IC5.142 (PE1), R22.2
unnamed: IC5.3 (PE4), R20.2
unnamed: IC5.58 (PE7), R6.1
unnamed: IC5.59 (PE8), R7.2
unnamed: IC5.60 (PE9), R32.1
unnamed: IC5.64 (PE11), R31.2
unnamed: IC5.66 (PE13), R29.2
unnamed: IC5.67 (PE14), R30.2
unnamed: IC5.124 (PG9), R47.2
unnamed: IC5.125 (PG10), R46.2
unnamed: IC5.126 (PG11), R45.2
unnamed: JP1.2 (C), R12.1

Notes on the sheet:
Decoupling
Debugger
SPARE PINS
Crystal
Bulk cap
LEDs signals
DMA config: - SPI3: Raspberry communication - SPI2: DC motors rotative encoders (daisy chain) - SPI1: pitch and yaw rotative encoders (daisy chain) - SPI4: 3 current sensors (with CSs) - Encoders mode for linear encoders
PB8-BOOT0 pin configuration: LOW: normal, boot from user flash HIGH: boot from system memory, bootloader
Supply decoupling
USB
Internal regulator capacitors
Analog supply
BOOT0
RESET
