DEDALUS-5x/axes-controller-board/axes-controller-board.kicad_pcb

## KiCad design axes-controller-board.kicad_pcb (continued)

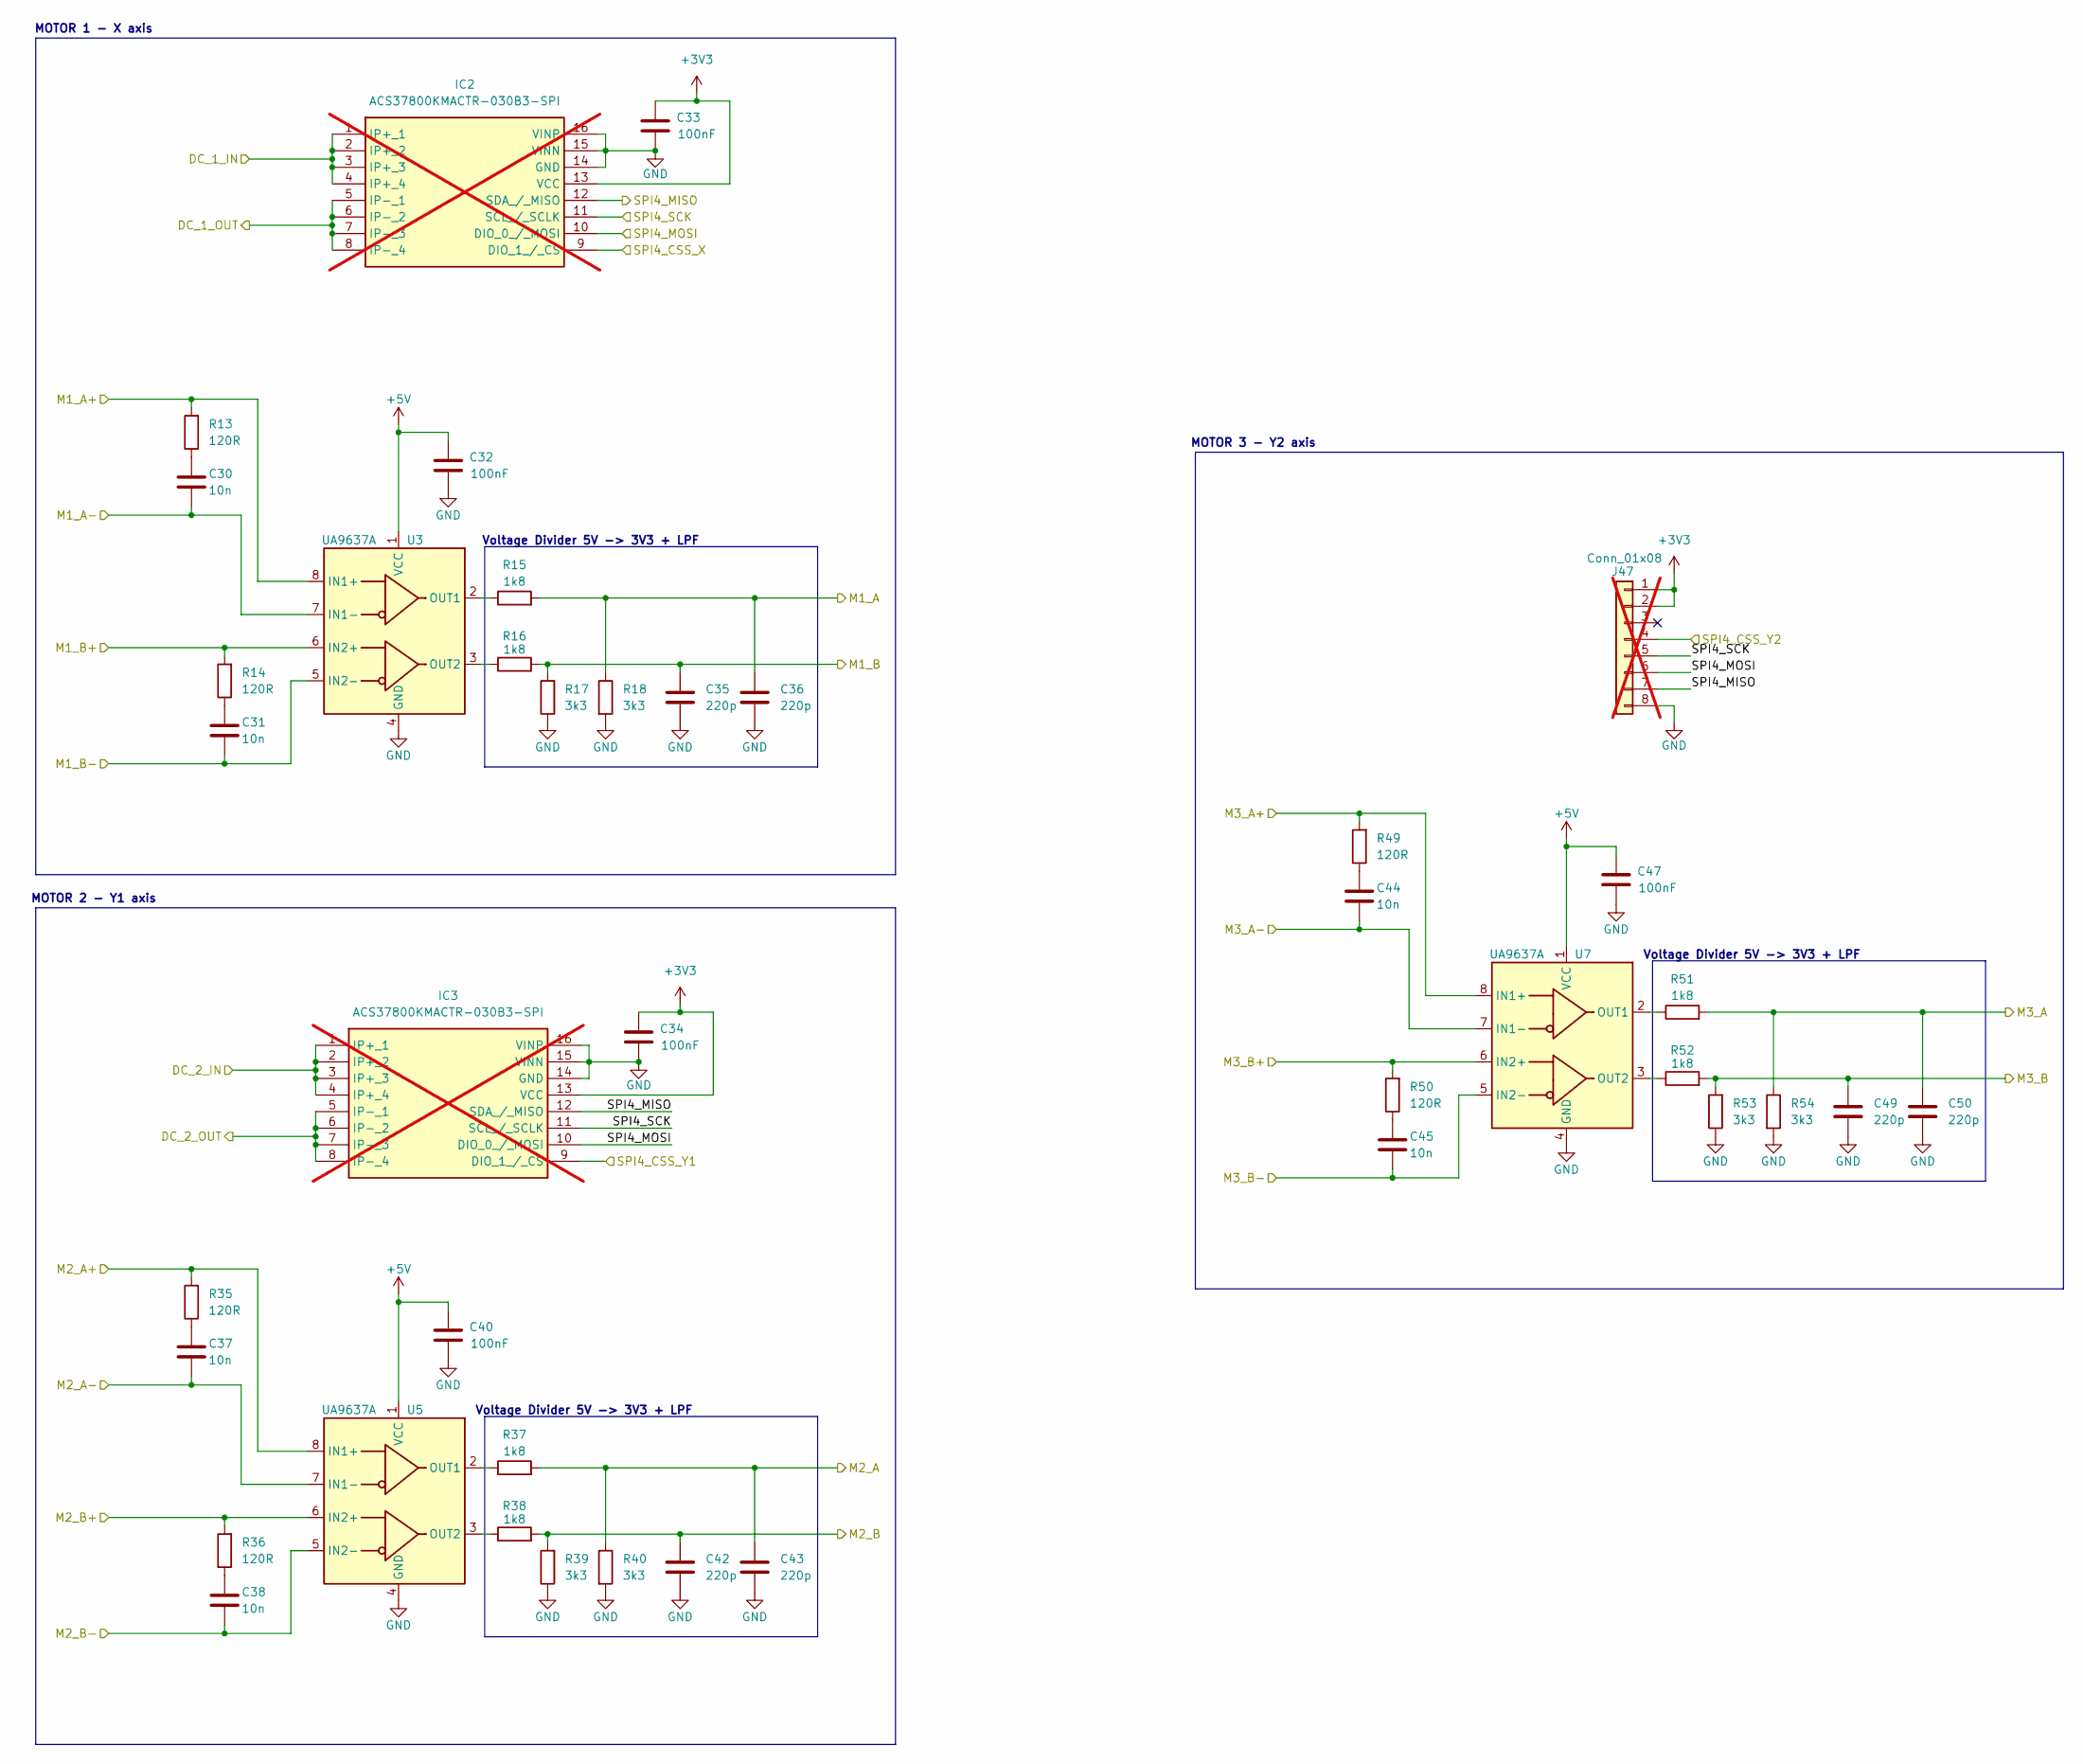
[picture p7: schematic sensors.kicad_sch]

Parts:
C30, C31, C37, C38, C44, C45: 10n; C_0603_1608Metric; LCSC C57112
C32, C33, C34, C40, C47: 100nF; C_0603_1608Metric; LCSC C14663
C35, C36, C42, C43, C49, C50: 220p; C_0603_1608Metric; LCSC C1603
IC2, IC3: ACS37800KMACTR-030B3-SPI; SOIC127P1030X265-16N; Mouser Part Number 250-KMACTR-030B3-SPI; not fitted
J47: Conn_01x08; PinHeader_1x08_P2.54mm_Vertical; not fitted
R13, R14, R35, R36, R49, R50: 120R; R_0603_1608Metric; LCSC C22787
R15, R16, R37, R38, R51, R52: 1k8; R_0603_1608Metric; LCSC C4177
R17, R18, R39, R40, R53, R54: 3k3; R_0603_1608Metric; LCSC C22978
U3, U5, U7: UA9637A; SOIC-8_3.9x4.9mm_P1.27mm; LCSC C434452

Connections:
+3V3: C33.1, C34.1, IC2.13 (VCC), IC3.13 (VCC), J47.1, J47.2; also elsewhere on the board
+5V: C32.1, C40.1, C47.1, U3.1 (VCC), U5.1 (VCC), U7.1 (VCC); also elsewhere on the board
/MCU/MX_A: C36.1, R15.2, R18.1; also elsewhere on the board
/MCU/MX_B: C35.1, R16.2, R17.2; also elsewhere on the board
/MCU/MY1_A: C43.1, R37.2, R40.1; also elsewhere on the board
/MCU/MY1_B: C42.1, R38.2, R39.2; also elsewhere on the board
/MCU/MY2_A: C50.1, R51.2, R54.1; also elsewhere on the board
/MCU/MY2_B: C49.1, R52.2, R53.2; also elsewhere on the board
/MCU/SPI4_CSS_X: IC2.9 (DIO_1_/_CS); also elsewhere on the board
/MCU/SPI4_CSS_Y1: IC3.9 (DIO_1_/_CS); also elsewhere on the board
/MCU/SPI4_CSS_Y2: J47.4; also elsewhere on the board
/Sensors/DC_1_IN: IC2.1 (IP+_1), IC2.2 (IP+_2), IC2.3 (IP+_3), IC2.4 (IP+_4); also elsewhere on the board
/Sensors/DC_1_OUT: IC2.5 (IP-_1), IC2.6 (IP-_2), IC2.7 (IP-_3), IC2.8 (IP-_4); also elsewhere on the board
/Sensors/DC_2_IN: IC3.1 (IP+_1), IC3.2 (IP+_2), IC3.3 (IP+_3), IC3.4 (IP+_4); also elsewhere on the board
/Sensors/DC_2_OUT: IC3.5 (IP-_1), IC3.6 (IP-_2), IC3.7 (IP-_3), IC3.8 (IP-_4); also elsewhere on the board
/Sensors/M1_A+: R13.2, U3.8 (IN1+); also elsewhere on the board
/Sensors/M1_A-: C30.2, U3.7 (IN1-); also elsewhere on the board
/Sensors/M1_B+: R14.2, U3.6 (IN2+); also elsewhere on the board
/Sensors/M1_B-: C31.2, U3.5 (IN2-); also elsewhere on the board
/Sensors/M2_A+: R35.2, U5.8 (IN1+); also elsewhere on the board
/Sensors/M2_A-: C37.2, U5.7 (IN1-); also elsewhere on the board
/Sensors/M2_B+: R36.2, U5.6 (IN2+); also elsewhere on the board
/Sensors/M2_B-: C38.2, U5.5 (IN2-); also elsewhere on the board
/Sensors/M3_A+: R49.2, U7.8 (IN1+); also elsewhere on the board
/Sensors/M3_A-: C44.2, U7.7 (IN1-); also elsewhere on the board
/Sensors/M3_B+: R50.2, U7.6 (IN2+); also elsewhere on the board
/Sensors/M3_B-: C45.2, U7.5 (IN2-); also elsewhere on the board
/Sensors/SPI4_MISO: IC2.12 (SDA_/_MISO), IC3.12 (SDA_/_MISO), J47.7; also elsewhere on the board
/Sensors/SPI4_MOSI: IC2.10 (DIO_0_/_MOSI), IC3.10 (DIO_0_/_MOSI), J47.6; also elsewhere on the board
/Sensors/SPI4_SCK: IC2.11 (SCL_/_SCLK), IC3.11 (SCL_/_SCLK), J47.5; also elsewhere on the board
GND: C32.2, C33.2, C34.2, C35.2, C36.2, C40.2, C42.2, C43.2, C47.2, C49.2, C50.2, IC2.14 (GND), IC2.15 (VINN), IC2.16 (VINP), IC3.14 (GND), IC3.15 (VINN), IC3.16 (VINP), J47.8, R17.1, R18.2, R39.1, R40.2, R53.1, R54.2, U3.4 (GND), U5.4 (GND), U7.4 (GND); also elsewhere on the board
unnamed: C30.1, R13.1
unnamed: C31.1, R14.1
unnamed: C37.1, R35.1
unnamed: C38.1, R36.1
unnamed: C44.1, R49.1
unnamed: C45.1, R50.1
unnamed: R15.1, U3.2 (OUT1)
unnamed: R16.1, U3.3 (OUT2)
unnamed: R37.1, U5.2 (OUT1)
unnamed: R38.1, U5.3 (OUT2)
unnamed: R51.1, U7.2 (OUT1)
unnamed: R52.1, U7.3 (OUT2)

Notes on the sheet:
Voltage Divider 5V -> 3V3 + LPF
MOTOR 3 - Y2 axis
MOTOR 2 - Y1 axis
MOTOR 1 - X axis

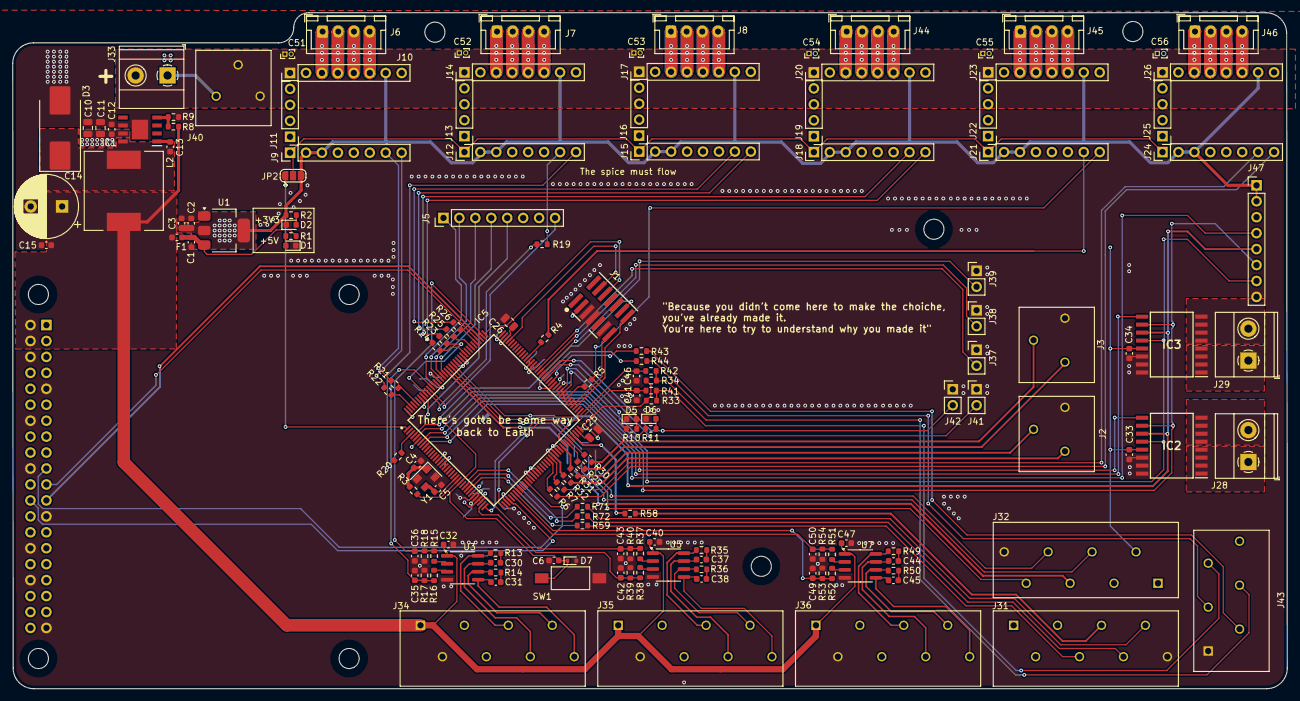
[picture p8: board axes-controller-board.kicad_pcb from above]

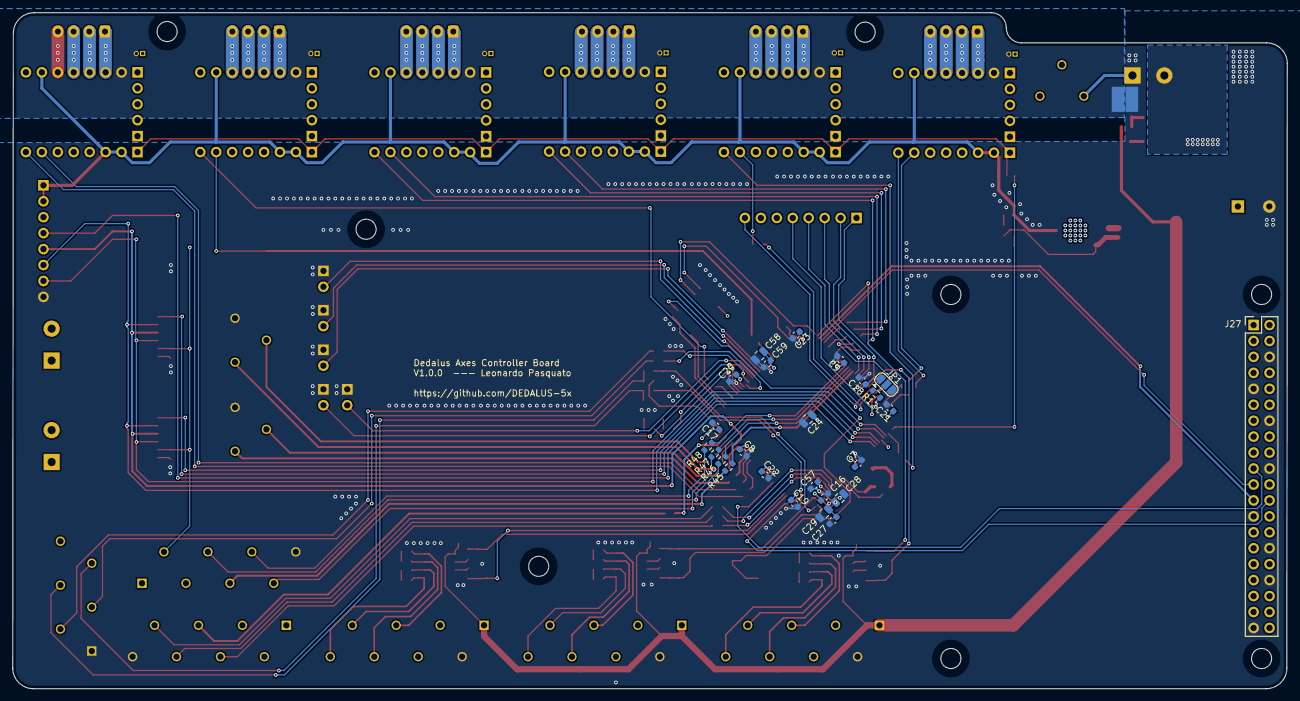
[picture p9: board axes-controller-board.kicad_pcb from below]

Board: 4 copper layers, 203.1 x 107.7 mm, 188 parts (25 on the bottom side), 164 nets.
