DEDALUS-5x/axes-controller-board/(commit log)

2026-01-24 feat: first schematic setup
2026-01-24 feat: 12 to 5V
2026-01-26 fix: 12V to 5V with TPS5450
    5V and 5A output, better choice for raspberry supply from it
2026-02-01 feat: setup encoder reading
2026-02-02 feat: RC filter on encoder data
2026-02-03 feat: voltage divider on UA96 inputs from new llinear encoder
2026-02-03 feat: linear encoders for all 3 dc motors
2026-02-03 feat: setup heatbed and nozzle connectors
2026-02-05 feat: setup stepper circuitry
2026-02-06 feat: pwm for dcs to micro, uart
2026-02-06 feat: setup spi
2026-02-07 feat: pwms for DC motors
2026-02-08 feat: raspberry spi dma setup and footprints fix
2026-02-13 fix: no voltage divider is needed on encoders input
2026-02-13 feat: linear encoders connections
2026-02-13 feat: connection micro to stepper motors drivers
2026-02-20 fix: missing footprints and new current sensor
2026-02-20 feat: config spi4 for current sensors
2026-02-21 feat: rotative encoders connectors setup
2026-02-23 feat: current sensor setup
2026-02-23 feat: setup micro on pcb
2026-02-23 feat: setup groups pcb
    steppers, micro, clock, current sensor - connector
2026-02-24 fix: missing input power connector
2026-02-24 feat: sbroglio encoders drivers
2026-02-24 feat: rasp, supply and micro setup on pcb, missing stepper motors connectors
2026-02-25 feat: 3d models and first draft pcb edge cuts
2026-02-25 fix: connectors and pcb layout
2026-02-25 feat: gnd zones
2026-02-26 feat: endstops integration
2026-02-26 feat: spi and 3v3 routing
2026-02-26 fix: 33R resistors
2026-02-27 feat: stepper motors connections to micro
2026-02-28 feat: dc driver connections
2026-02-28 fix: silkscreen
2026-02-28 feat: endstops connections
2026-03-02 fix: ground planes
2026-03-02 feat: nozzle and hb connections
2026-03-03 fix: nozzle and hb connector
2026-03-03 fix: 3d 6 pin connector libs, fix DRC
2026-03-03 feat: mounting holes
2026-03-03 fix: spi sck wider traces and minors
2026-03-03 fix: gnd vias and comments
2026-03-03 fix: collision between encoder connector and raspberry aux
2026-03-04 feat: LCSC codes for all components to be soldered
2026-03-05 fix: DNP for current sensors
2026-03-05 feat: stepper connectors
2026-03-09 feat: 33R resistors on SPI1 and 2
2026-03-09 feat: stepper connections phases
2026-03-09 fix: missing traces
2026-03-19 fix: missing resistors
2026-11-08 fix: updated traces with manual corrections from v1.0
