DEDALUS-5x/axes-controller-board/(notices)

Notices in the files:
axes-controller-board.kicad_pcb:
Licensed under CERN-OHL-S-2.0, https://ohwr.org/cern_ohl_s_v2.txt
Distributed WITHOUT ANY WARRANTY, see LICENSE
